BleuLlama/USB_DSKY/Arduino/schematicish.gif

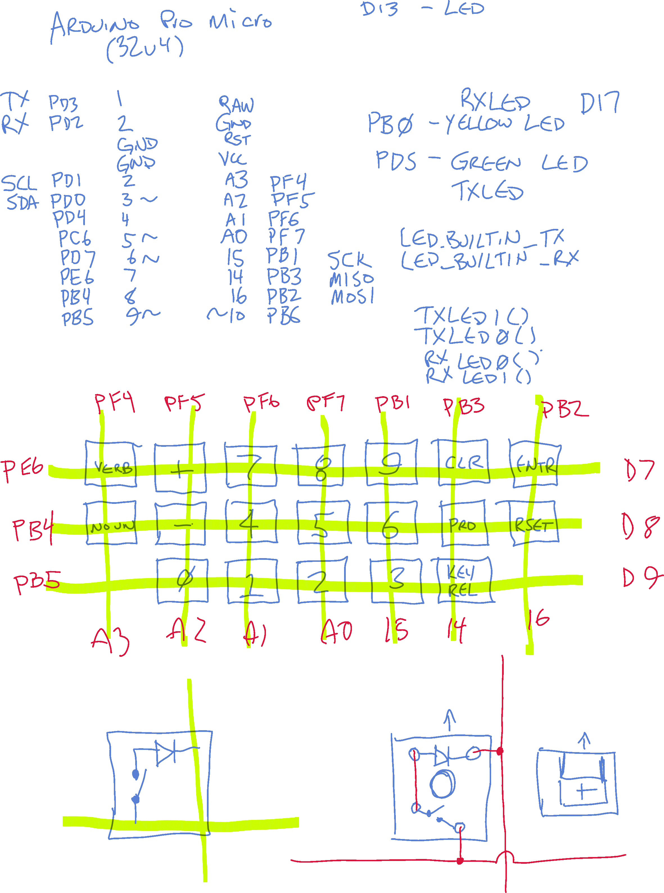
Arduino/schematicish.gif
