BleuLlama/USB_DSKY/Enclosure/reference_0071.jpg

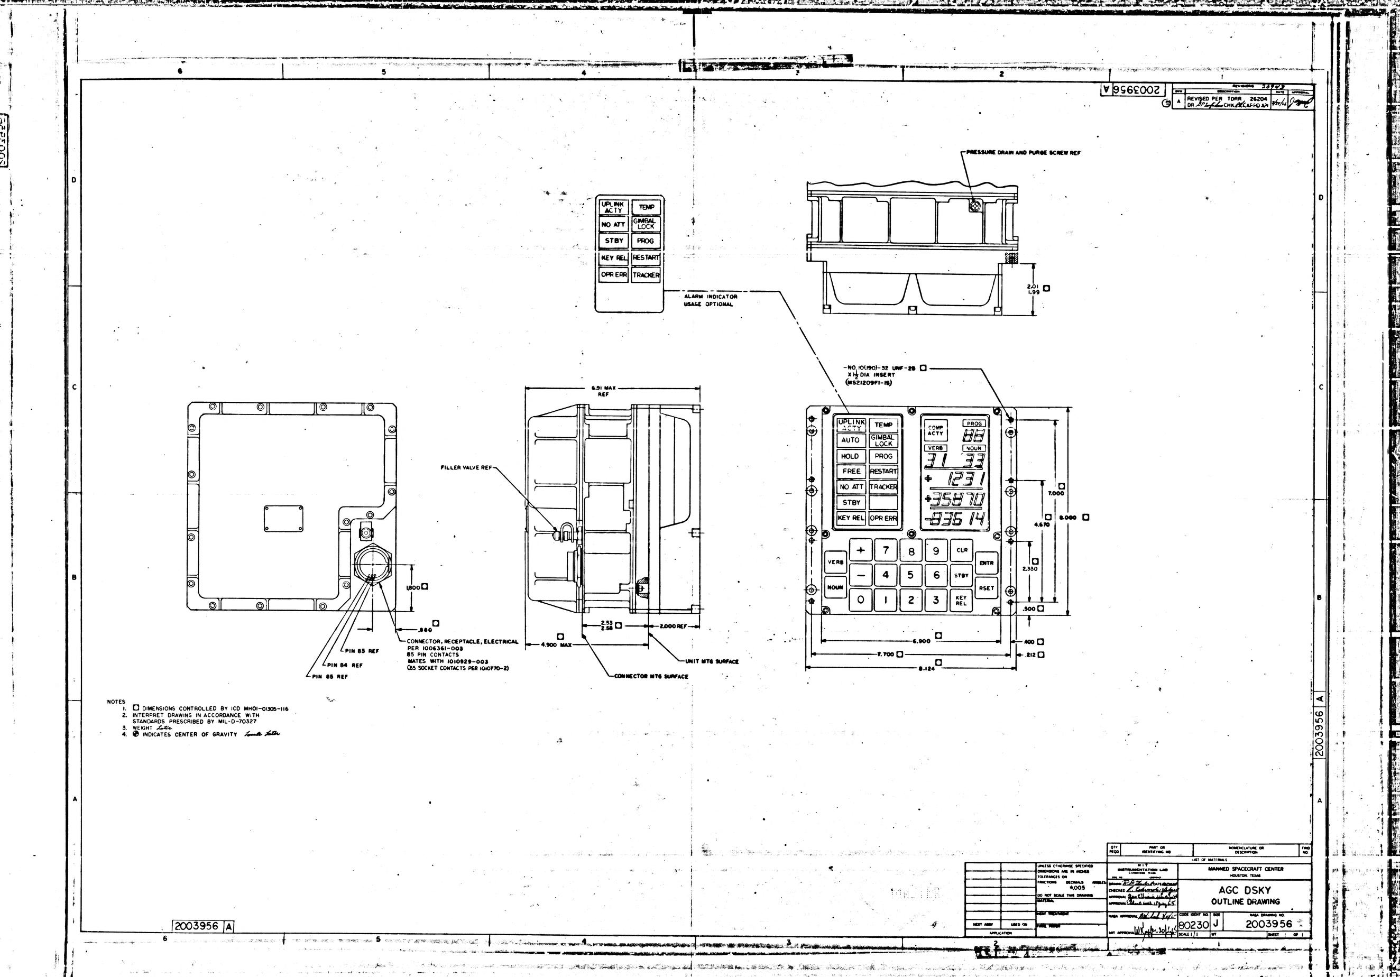
Enclosure/reference_0071.jpg
