BleuLlama/USB_DSKY/Enclosure/reference_0075.jpg

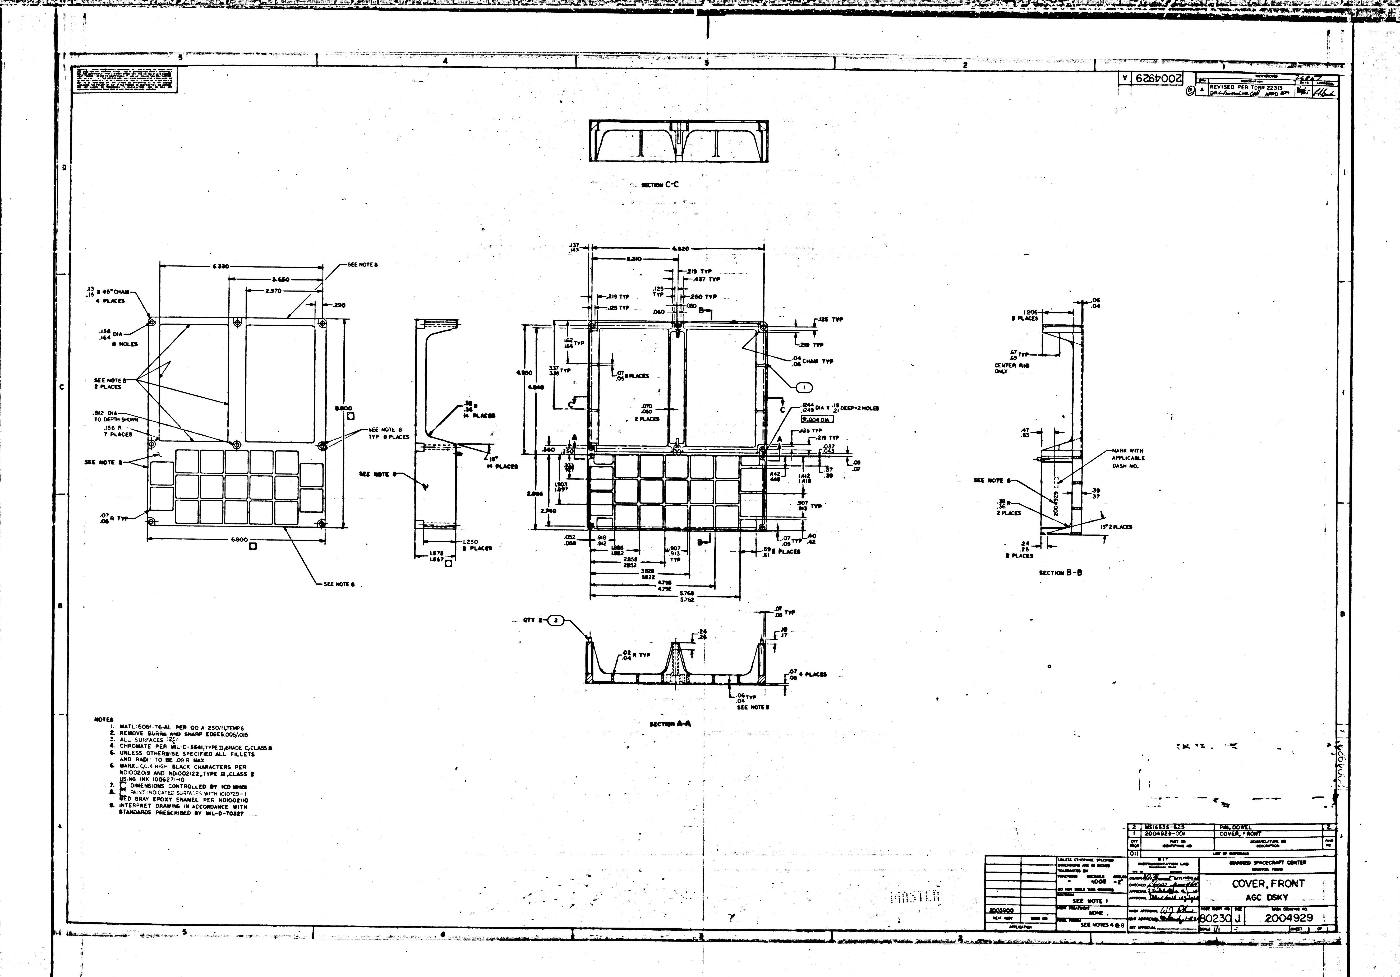
Enclosure/reference_0075.jpg
