BleuLlama/USB_DSKY/Images/00_lasercut.jpg

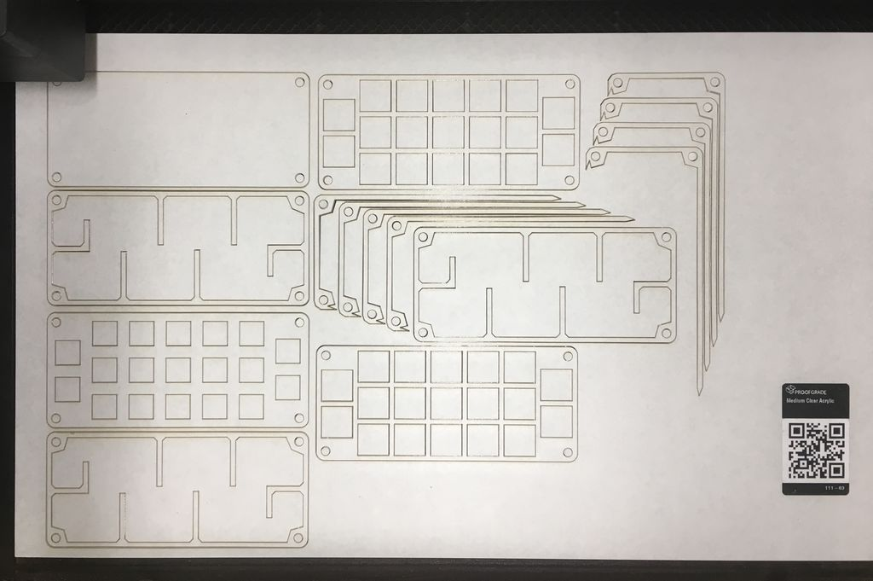
Images/00_lasercut.jpg
