BleuLlama/USB_DSKY/Enclosure/enclosure.pdf

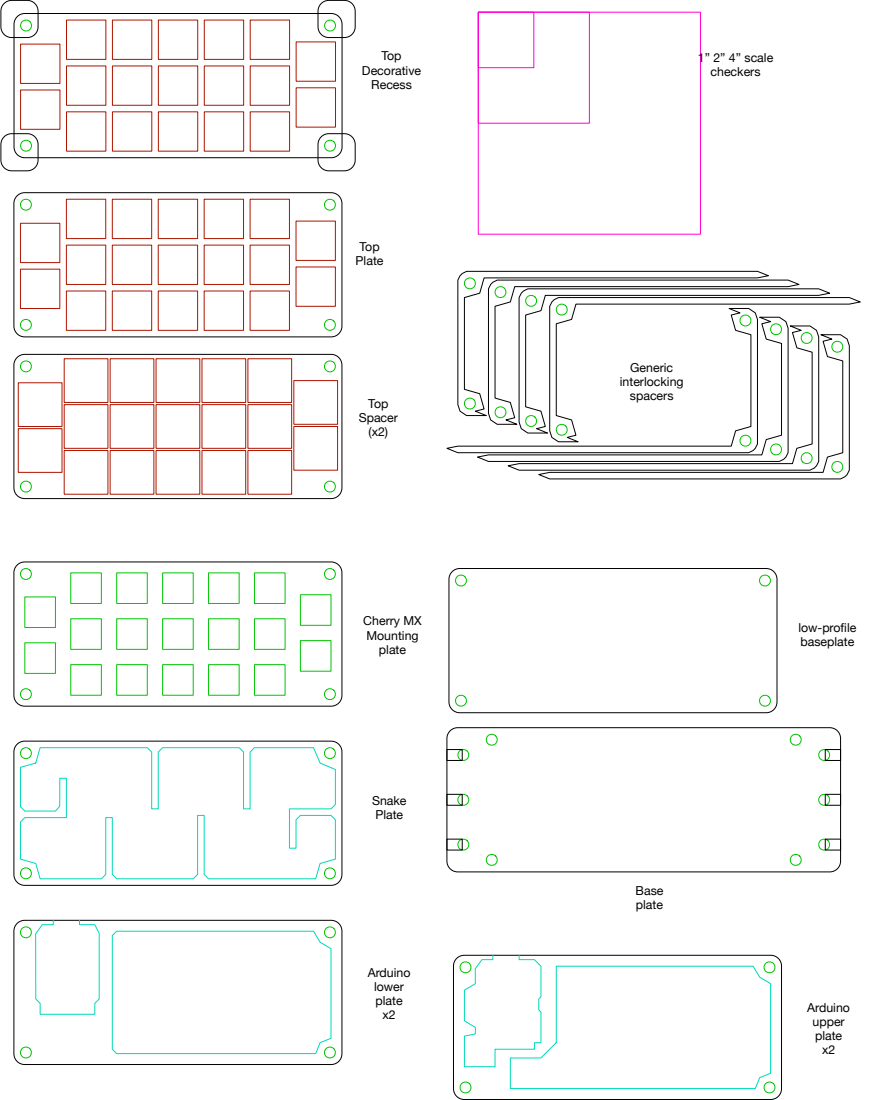
[picture p6: page 1]
Generic interlocking spacers; 1” 2” 4” scale checkers; Arduino lower plate x2; Top Spacer (x2); Top Decorative Recess; Base plate; Top Plate; low-profile baseplate; Snake Plate; Cherry MX Mounting plate; Arduino upper plate x2
