BleuLlama/USB_DSKY/Images/01_construction.jpg

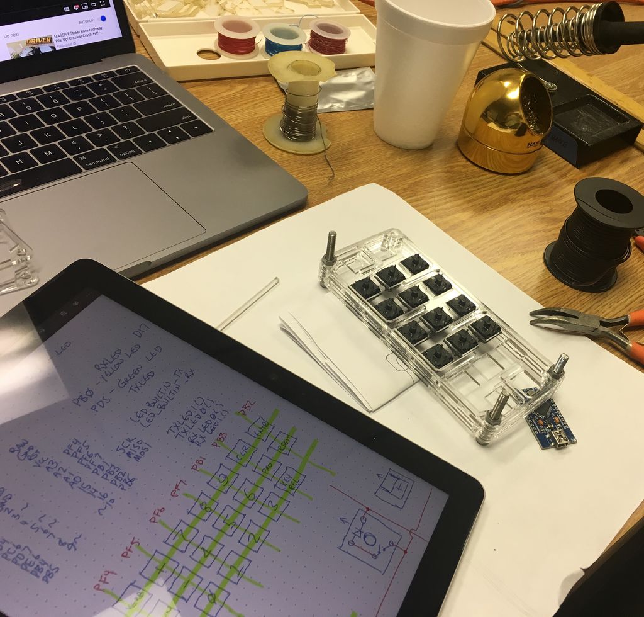
Images/01_construction.jpg
