BleuLlama/USB_DSKY/Images/02_wiring_the_matrix.jpg

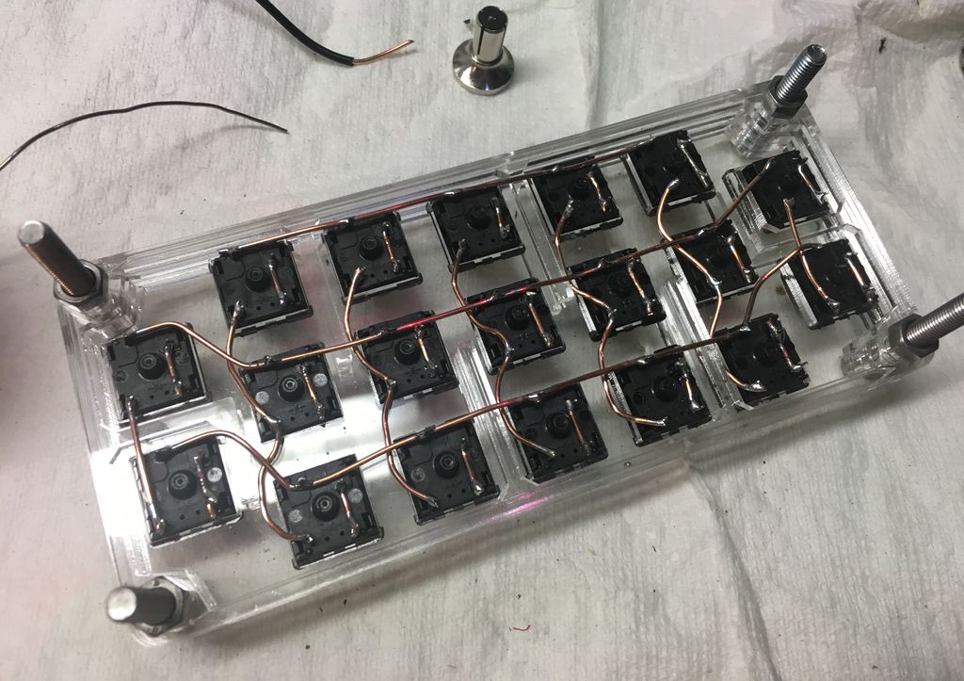
Images/02_wiring_the_matrix.jpg
