BleuLlama/USB_DSKY/Images/03_wiring_to_micro.jpg

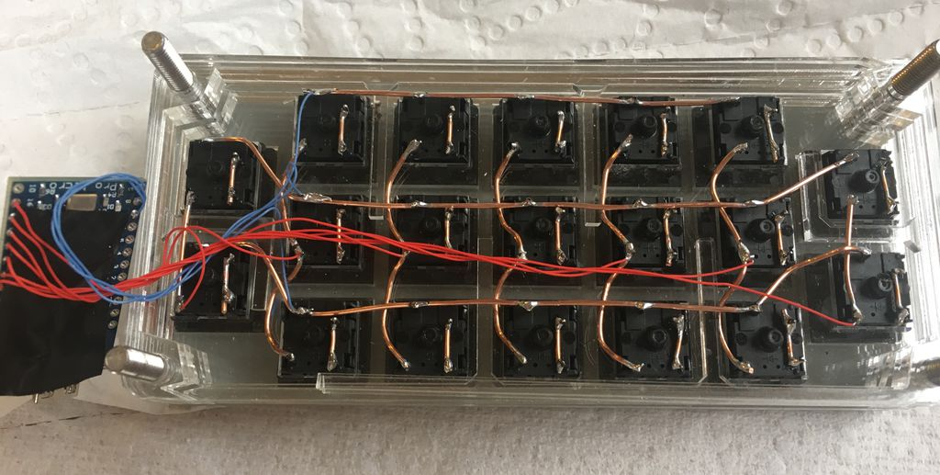
Images/03_wiring_to_micro.jpg
